Doma1204/ELEC3300-Smart_Clock_Project/ESP8266/README.md

# ESP8266 Side Program
In this project, ESP8266 mainly provide Internet access. It connect with the STM23F4 mainboard via UART. It uses Arduino to program.
ESP-01 is used in this project.

### Library used
- Arduino ESP8266 Library
