Doma1204/ELEC3300-Smart_Clock_Project/PCB/Smart_Clock_Mainboard/Smart_Clock_Mainboard.xls

Sheet: BOM Report
Bill of Materials |  |  | Bill of Materials for Project [Smart_Clock_Mainboard.PrjPcb] (No PCB Document Selected)
Source Data From: |  | Smart_Clock_Mainboard.PrjPcb
Project: |  | Smart_Clock_Mainboard.PrjPcb
Variant: |  | None
Creation Date: | 15/11/2019 | 下午12:44
Print Date: | 2019-11-15 | 12:44:18
Footprint | Comment | LibRef | Designator | Description | Quantity
CR2012-0805 | 56R | Res Semi | 1 | Semiconductor Resistor | 1
CR2012-0805 | 56R | Res Semi | 2 | Semiconductor Resistor | 1
CR2012-0805 | Res Semi | Res Semi | 56R | Semiconductor Resistor | 1
HDR1X2 | Boot | Header 2 | Boot | Header, 2-Pin | 1
PUSH SWITCH 2-PIN | B1 | SW-SPST | BT1 | Single-Pole, Single-Throw Switch | 1
PUSH SWITCH 2-PIN | B2 | SW-SPST | BT2 | Single-Pole, Single-Throw Switch | 1
PUSH SWITCH 2-PIN | B3 | SW-SPST | BT3 | Single-Pole, Single-Throw Switch | 1
CC2012-0805 | 2.2uF | Cap Semi | C1 | Capacitor (Semiconductor SIM Model) | 1
CC2012-0805 | 100nF | Cap Semi | C2 | Capacitor (Semiconductor SIM Model) | 1
CC2012-0805 | 100nF | Cap Semi | C3 | Capacitor (Semiconductor SIM Model) | 1
CC2012-0805 | 20nF | Cap Semi | C4 | Capacitor (Semiconductor SIM Model) | 1
CC2012-0805 | 20nF | Cap Semi | C5 | Capacitor (Semiconductor SIM Model) | 1
CC2012-0805 | 100nF | Cap Semi | C6 | Capacitor (Semiconductor SIM Model) | 1
CC2012-0805 | 100nF | Cap Semi | C7 | Capacitor (Semiconductor SIM Model) | 1
CC2012-0805 | 2.2uF | Cap Semi | C8 | Capacitor (Semiconductor SIM Model) | 1
CC2012-0805 | 2.2uF | Cap Semi | C9 | Capacitor (Semiconductor SIM Model) | 1
CC2012-0805 | 100nF | Cap Semi | C10 | Capacitor (Semiconductor SIM Model) | 1
CC2012-0805 | 100nF | Cap Semi | C11 | Capacitor (Semiconductor SIM Model) | 1
CC2012-0805 | 100nF | Cap Semi | C12 | Capacitor (Semiconductor SIM Model) | 1
CC2012-0805 | 100nF | Cap Semi | C13 | Capacitor (Semiconductor SIM Model) | 1
CC2012-0805 | 100nF | Cap Semi | C14 | Capacitor (Semiconductor SIM Model) | 1
CC2012-0805 | 100nF | Cap Semi | C15 | Capacitor (Semiconductor SIM Model) | 1
CC2012-0805 | 100nF | Cap Semi | C16 | Capacitor (Semiconductor SIM Model) | 1
CC2012-0805 | 100nF | Cap Semi | C17 | Capacitor (Semiconductor SIM Model) | 1
CC2012-0805 | 100nF | Cap Semi | C18 | Capacitor (Semiconductor SIM Model) | 1
CC2012-0805 | 100nF | Cap Semi | C19 | Capacitor (Semiconductor SIM Model) | 1
CC2012-0805 | 100nF | Cap Semi | C20 | Capacitor (Semiconductor SIM Model) | 1
CC2012-0805 | 100nF | Cap Semi | C21 | Capacitor (Semiconductor SIM Model) | 1
CC2012-0805 | 100nF | Cap Semi | C22 | Capacitor (Semiconductor SIM Model) | 1
CC2012-0805 | 100nF | Cap Semi | C23 | Capacitor (Semiconductor SIM Model) | 1
CC2012-0805 | 100nF | Cap Semi | C24 | Capacitor (Semiconductor SIM Model) | 1
CC2012-0805 | 100nF | Cap Semi | C25 | Capacitor (Semiconductor SIM Model) | 1
CC2012-0805 | 10uF | Cap Semi | C26 | Capacitor (Semiconductor SIM Model) | 1
CC2012-0805 | 10uF | Cap Semi | C27 | Capacitor (Semiconductor SIM Model) | 1
CC2012-0805 | 10uF | Cap Semi | C28 | Capacitor (Semiconductor SIM Model) | 1
CC2012-0805 | 10uF | Cap Semi | C29 | Capacitor (Semiconductor SIM Model) | 1
D0805 | LED | LED | D1 | Typical RED GaAs LED | 1
D0805 | LED | LED | D2 | Typical RED GaAs LED | 1
D0805 | LED | LED | D3 | Typical RED GaAs LED | 1
D0805 | LED | LED | D4 | Typical RED GaAs LED | 1
D0805 | LED | LED | D5 | Typical RED GaAs LED | 1
D0805 | LED | LED | D6 | Typical RED GaAs LED | 1
HDR1X3 | ESP_EN | Header 3 | ESP_EN | Header, 3-Pin | 1
HDR1X3 | ESP_IO0 | Header 3 | ESP_IO0 | Header, 3-Pin | 1
PUSH SWITCH 2-PIN | ESP_RST | SW-SPST | ESP_RST | Single-Pole, Single-Throw Switch | 1
LOCKEDHDR-4W | ESP_UART | Header 4 | ESP_UART | Header, 4-Pin | 1
HDR2X7 | ISP | Header 7X2 | GPIO | Header, 7-Pin, Dual row | 1
HDR1X4 | CONN0M | Header 4 | GY-39 | Header, 4-Pin | 1
HDR1X2 | MOTOR | Header 2 | GY-39_JP | Header, 2-Pin | 1
HDR1.27_2x4 | ISP | Header 4X2 | ISP | Header, 5-Pin, Dual row | 1
HDR1X4 | Header 4 | Header 4 | MIC | Header, 4-Pin | 1
HDR1X10 | Header10 | Header 10 | MPU | Header, 10-Pin | 1
BUZ-9.0 | Buzzer | Buzzer | P1 |  | 1
HDR1X3 | PIR | Header 3 | PIR | Header, 3-Pin | 1
SO-G3/Z3.3 | AO3400 | AO3400 | Q1 | N-Channel MOSFET | 1
CR2012-0805 | 330R | Res Semi | R1 | Semiconductor Resistor | 1
CR2012-0805 | 330R | Res Semi | R2 | Semiconductor Resistor | 1
CR2012-0805 | 330R | Res Semi | R3 | Semiconductor Resistor | 1
CR2012-0805 | 330R | Res Semi | R4 | Semiconductor Resistor | 1
CR2012-0805 | 330R | Res Semi | R5 | Semiconductor Resistor | 1
CR2012-0805 | 330R | Res Semi | R6 | Semiconductor Resistor | 1
CR2012-0805 | 10k | Res Semi | R7 | Semiconductor Resistor | 1
CR2012-0805 | 33R | Res Semi | R8 | Semiconductor Resistor | 1
ARC241-0603x4 | 56R | Res Array | R9 | 4x Resistor Array | 1
ARC241-0603x4 | 56R | Res Array | R10 | 4x Resistor Array | 1
HDR1X10 | Header 10 | Header 10 | RGB | Header, 10-Pin | 1
PUSH SWITCH 2-PIN | RESET | SW-SPST | RST | Single-Pole, Single-Throw Switch | 1
HDR1X6 | SPI3 | Header 6 | SPI3 | Header, 6-Pin | 1
LOCKEDHDR-4W | Header 4 | Header 4 | SWD | Header, 4-Pin | 1
SD-502774-0811 | TF CD Socket | TF CD Socket | TF | TF Card Socket with Spring with Card Detection | 1
HDR1X11 | TFT | Header 11 | TFT | Header, 11-Pin | 1
LQFP144_M | STM32F407ZET6 | STM32F407ZET6 | U1 | STM32 ARM-based 32-bit MCU with 64 Kbytes Flash, 144-pin LQFP, Industrial Temperature | 1
MP04A_N | LM1117MP-3.3 | LM1117MP-3.3 | U2 | 800mA Low-Dropout Linear Regulator | 1
MP04A_N | LM1117MP-3.3 | LM1117MP-3.3 | U3 | 800mA Low-Dropout Linear Regulator | 1
LOCKEDHDR-4W | UART6 | Header 4 | UART6 | Header, 4-Pin | 1
BCY-W2/E4.7 | 8.00MHz | XTAL | X1 | Crystal Oscillator | 1
 |  |  |  |  | 76
Approved |  | Notes

Sheet: Project Information
Project Full Path | \\Mac\Home\Documents\GitHub\ELEC3300-Smart_Clock_Project\PCB\Smart_Clock_Mainboard\Smart_Clock_Mainboard.PrjPcb
Project Filename | Smart_Clock_Mainboard.PrjPcb
Variant Name | None
Data-Source Filename | Smart_Clock_Mainboard.PrjPcb
Data-Source Full Path | \\Mac\Home\Documents\GitHub\ELEC3300-Smart_Clock_Project\PCB\Smart_Clock_Mainboard\Smart_Clock_Mainboard.PrjPcb
Title | Bill of Materials for Project [Smart_Clock_Mainboard.PrjPcb] (No PCB Document Selected)
Total Quantity | 76
Report Time | 下午12:44
Report Date | 15/11/2019
Report Date & Tine | 15/11/2019 下午12:44
Output Name | Bill of Materials
Output Type | BOM_PartType
Output Generator Name | BOM
Output Generator Description | Bill of Materials
