Doma1204/ELEC3300-Smart_Clock_Project/PCB/Smart_Clock_Mainboard/Smart_Clock_Mainboard.pdf

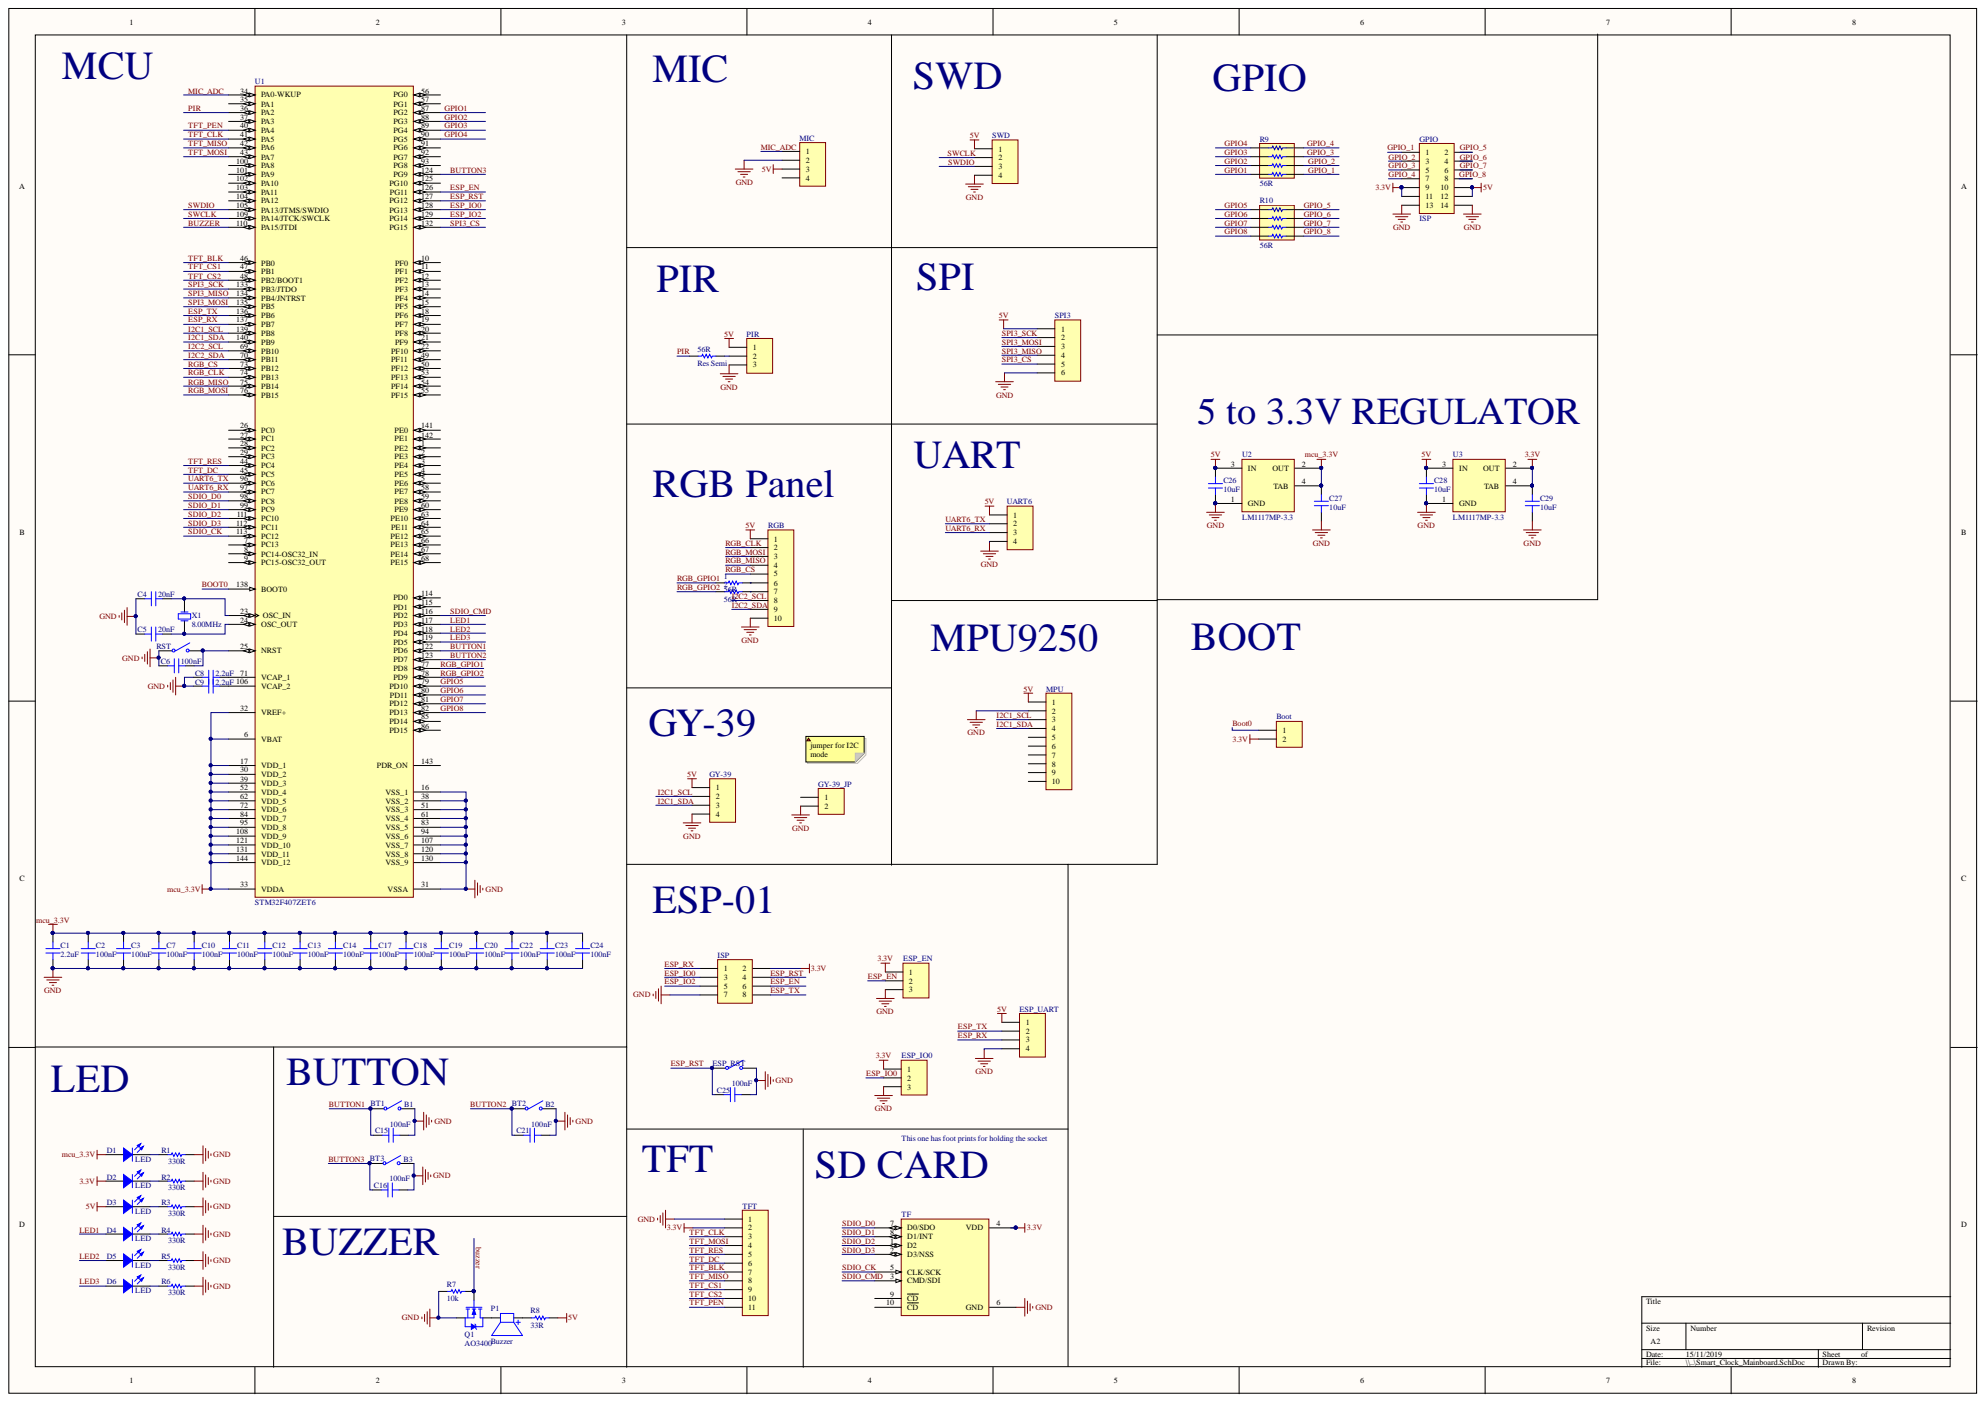
[picture p1: page 1]

This one hasfoot prints for holding the socket

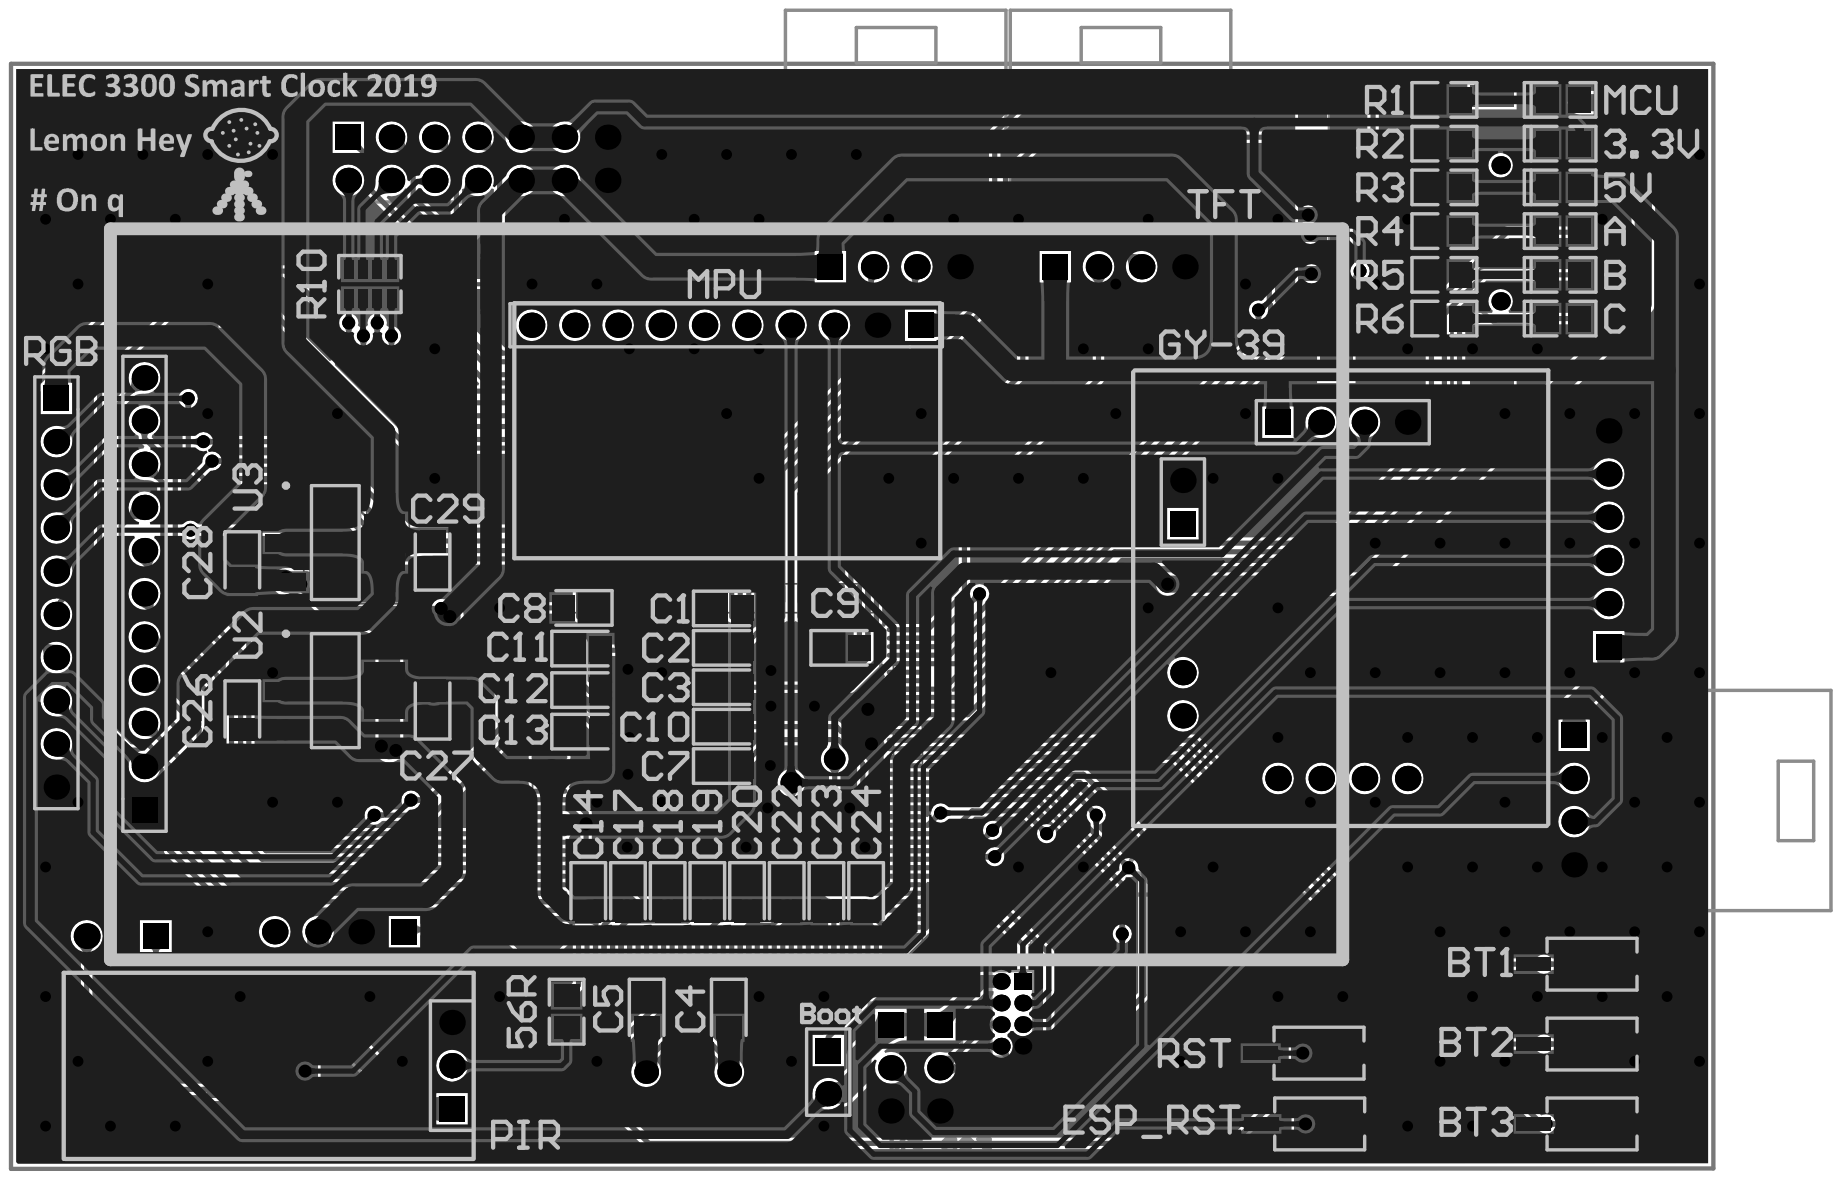
[picture p2: page 2]
