Doma1204/ELEC3300-Smart_Clock_Project/(list of files, drawings)

Other design files:
PCB/Smart_Clock_Mainboard/History/Smart_Clock_Mainboard.~(1).PrjPcb
PCB/Smart_Clock_Mainboard/Smart_Clock_Mainboard.PcbDoc
PCB/Smart_Clock_Mainboard/Smart_Clock_Mainboard.PrjPcb
PCB/Smart_Clock_Mainboard/Smart_Clock_Mainboard.SchDoc
