Doma1204/ELEC3300-Smart_Clock_Project/Smart_Clock/Src/main.c

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

/* Includes ------------------------------------------------------------------*/
#include "main.h"
#include "dma.h"
#include "fatfs.h"
#include "i2c.h"
#include "sdio.h"
#include "spi.h"
#include "tim.h"
#include "usart.h"
#include "gpio.h"

/* USER CODE BEGIN Includes */
#include "led.h"
#include "button.h"
#include "tft.h"
#include "WS2812.h"
#include "esp8266.h"
#include "pir.h"
#include "xpt2046.h"
#include "gy39.h"
#include "file.h"
#include "strhelper.h"
#include "UI.h"
#include "rgb.h"
/* USER CODE END Includes */


void SystemClock_Config(void);
/* USER CODE BEGIN 0 */

// static uint8_t sun[350], dry[350], cold[350];
/* USER CODE END 0 */

/**
  * @brief  The application entry point.
  * @retval int
  */
int main(void)
{
  

  /* MCU Configuration--------------------------------------------------------*/

  /* Reset of all peripherals, Initializes the Flash interface and the Systick. */
  HAL_Init();

  /* Configure the system clock */
  SystemClock_Config();

  /* Initialize all configured peripherals */
  MX_GPIO_Init();
  MX_DMA_Init();
  MX_SDIO_SD_Init();
  MX_SPI1_Init();
  MX_TIM3_Init();
  MX_USART1_UART_Init();
  MX_I2C1_Init();
  // MX_I2C2_Init();
  MX_FATFS_Init();
  /* USER CODE BEGIN 2 */
  PIR_init();
  led_blink(LED1, 500);
  tft_init(PIN_ON_LEFT, BLACK, WHITE, GREEN, RED);
  requestTemperature(Wong_Chuk_Hang);

  ws2812_start_search_panel();

  UI_init();
  
  extern uint8_t wsBuffer[4];
  extern uint8_t panel_look_up[MAX_NUM_PANEL][MAX_NUM_PANEL];
  extern WS2812_STRUCT panel[MAX_NUM_PANEL];
  extern uint8_t rgb_inited;
  /* USER CODE END 2 */

  /* Infinite loop */
  /* USER CODE BEGIN WHILE */
  while (1)
  {
    /* USER CODE END WHILE */

    /* USER CODE BEGIN 3 */
    static uint32_t last_tft_ticks = 0;
    if (HAL_GetTick() - last_tft_ticks >= TFT_UPDATE_FREQUENCY) {
      UI_update();
      rgb_update();
      tft_update();
      ws2812_update();
      last_tft_ticks = HAL_GetTick();
    }

    led_update();
    button_update();
    esp_update();
    gy39_update();
  }
  /* USER CODE END 3 */
}

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
