Doma1204/ELEC3300-Smart_Clock_Project/RGB_Panel/Src/gpio.c

/**
  ******************************************************************************
  * File Name          : gpio.c
  * Description        : This file provides code for the configuration
  *                      of all used GPIO pins.
  ******************************************************************************
  * @attention
  *
  * <h2><center>&copy; Copyright (c) 2019 STMicroelectronics.
  * All rights reserved.</center></h2>
  *
  * This software component is licensed by ST under BSD 3-Clause license,
  * the "License"; You may not use this file except in compliance with the
  * License. You may obtain a copy of the License at:
  *                        opensource.org/licenses/BSD-3-Clause
  *
  ******************************************************************************
  */

/* Includes ------------------------------------------------------------------*/
#include "gpio.h"
/* USER CODE BEGIN 0 */
const GPIO
ALL_DIR_PORT = {TOP_GPIO_Port, TOP_Pin|BOTTOM_Pin|RIGHT_Pin|LEFT_Pin},
TOP_PORT = {TOP_GPIO_Port, TOP_Pin},
BOTTOM_PORT = {BOTTOM_GPIO_Port, BOTTOM_Pin},
LEFT_PORT = {LEFT_GPIO_Port, LEFT_Pin},
RIGHT_PORT = {RIGHT_GPIO_Port, RIGHT_Pin},
SCL_PORT = {SCL_GPIO_Port, SCL_Pin},
SDA_PORT = {SDA_GPIO_Port, SDA_Pin};
/* USER CODE END 0 */

/*----------------------------------------------------------------------------*/
/* Configure GPIO                                                             */
/*----------------------------------------------------------------------------*/
/** Configure pins as 
        * Analog 
        * Input 
        * Output
        * EVENT_OUT
        * EXTI
*/
void MX_GPIO_Init(void)
{

  GPIO_InitTypeDef GPIO_InitStruct = {0};

  /* GPIO Ports Clock Enable */
  __HAL_RCC_GPIOF_CLK_ENABLE();
  __HAL_RCC_GPIOA_CLK_ENABLE();

  /*Configure GPIO pin Output Level */
  HAL_GPIO_WritePin(LED_GPIO_Port, LED_Pin, GPIO_PIN_SET);

  /*Configure GPIO pin : PtPin */
  GPIO_InitStruct.Pin = LED_Pin;
  GPIO_InitStruct.Mode = GPIO_MODE_OUTPUT_PP;
  GPIO_InitStruct.Pull = GPIO_NOPULL;
  GPIO_InitStruct.Speed = GPIO_SPEED_FREQ_HIGH;
  HAL_GPIO_Init(LED_GPIO_Port, &GPIO_InitStruct);

  /* EXTI interrupt init*/
  HAL_NVIC_SetPriority(EXTI0_1_IRQn, 0, 0);
  HAL_NVIC_EnableIRQ(EXTI0_1_IRQn);

  HAL_NVIC_SetPriority(EXTI4_15_IRQn, 0, 0);
  HAL_NVIC_EnableIRQ(EXTI4_15_IRQn);
}

/* USER CODE BEGIN 2 */
void signal_detect_rising_gpio_init(const GPIO* gpio) {
  HAL_GPIO_DeInit(gpio->port, gpio->pin);
  GPIO_InitTypeDef GPIO_InitStruct = {0};
  GPIO_InitStruct.Pin = gpio->pin;
  GPIO_InitStruct.Mode = GPIO_MODE_IT_RISING;
  GPIO_InitStruct.Pull = GPIO_NOPULL;
  HAL_GPIO_Init(gpio->port, &GPIO_InitStruct);
}

void signal_detect_falling_gpio_init(const GPIO* gpio) {
  HAL_GPIO_DeInit(gpio->port, gpio->pin);
  GPIO_InitTypeDef GPIO_InitStruct = {0};
  GPIO_InitStruct.Pin = gpio->pin;
  GPIO_InitStruct.Mode = GPIO_MODE_IT_FALLING;
  GPIO_InitStruct.Pull = GPIO_PULLUP;
  HAL_GPIO_Init(gpio->port, &GPIO_InitStruct);
}

void signal_emit_gpio_init(const GPIO* gpio) {
  HAL_GPIO_DeInit(gpio->port, gpio->pin);
  GPIO_InitTypeDef GPIO_InitStruct = {0};
  GPIO_InitStruct.Pin = gpio->pin;
  GPIO_InitStruct.Mode = GPIO_MODE_OUTPUT_PP;
  GPIO_InitStruct.Pull = GPIO_NOPULL;
  GPIO_InitStruct.Speed = GPIO_SPEED_FREQ_HIGH;
  HAL_GPIO_Init(gpio->port, &GPIO_InitStruct);
}
/* USER CODE END 2 */

/************************ (C) COPYRIGHT STMicroelectronics *****END OF FILE****/
