Doma1204/ELEC3300-Smart_Clock_Project/RGB_Panel/Inc/gpio.h

/**
  ******************************************************************************
  * File Name          : gpio.h
  * Description        : This file contains all the functions prototypes for 
  *                      the gpio  
  ******************************************************************************
  * @attention
  *
  * <h2><center>&copy; Copyright (c) 2019 STMicroelectronics.
  * All rights reserved.</center></h2>
  *
  * This software component is licensed by ST under BSD 3-Clause license,
  * the "License"; You may not use this file except in compliance with the
  * License. You may obtain a copy of the License at:
  *                        opensource.org/licenses/BSD-3-Clause
  *
  ******************************************************************************
  */

/* Define to prevent recursive inclusion -------------------------------------*/
#ifndef __gpio_H
#define __gpio_H
#ifdef __cplusplus
 extern "C" {
#endif

/* Includes ------------------------------------------------------------------*/
#include "main.h"

/* USER CODE BEGIN Private defines */
typedef struct _GPIO {
  GPIO_TypeDef* port;
  uint16_t pin;
} GPIO;

extern const GPIO ALL_DIR_PORT, TOP_PORT, BOTTOM_PORT, LEFT_PORT, RIGHT_PORT, SCL_PORT, SDA_PORT;
/* USER CODE END Private defines */

void MX_GPIO_Init(void);

/* USER CODE BEGIN Prototypes */
void signal_detect_rising_gpio_init(const GPIO* gpio);
void signal_detect_falling_gpio_init(const GPIO* gpio);
void signal_emit_gpio_init(const GPIO* gpio);
/* USER CODE END Prototypes */

#ifdef __cplusplus
}
#endif
#endif /*__ pinoutConfig_H */

/**
  * @}
  */

/**
  * @}
  */

/************************ (C) COPYRIGHT STMicroelectronics *****END OF FILE****/
