Doma1204/ELEC3300-Smart_Clock_Project/(commit log)

2019-10-31 finish smart clock pin config and new datasheet
2019-10-31 update on pin config
2019-11-02 start drawing schematic of the mainboard
    [Smart_Clock_Mainboard.PrjPcb, Smart_Clock_Mainboard.SchDoc]
2019-11-06 upload sch
    [Smart_Clock_Mainboard.SchDoc, Smart_Clock_Mainboard.~(1).PrjPcb]
2019-11-12 Update schematic and pcb file of mainboard
    [Smart_Clock_Mainboard.PcbDoc, Smart_Clock_Mainboard.PrjPcb, Smart_Clock_Mainboard.SchDoc]
2019-11-13 First version of mainboard
    [Smart_Clock_Mainboard.PcbDoc, Smart_Clock_Mainboard.PrjPcb, Smart_Clock_Mainboard.SchDoc]
2019-11-13 Changed ESP Uart position and added name
2019-11-15 Upload PDF version of schematic and BOM
    [Smart_Clock_Mainboard.xls]
2019-11-21 finally the LEDs work
2019-11-22 update Cube Mx
    [Smart_Clock_Mainboard.PrjPcb, Smart_Clock_Mainboard.xls]
